HashNick/ZeroTwo-PlataformaRoboticaMultiagenteALIFE/Anexo1.pdf

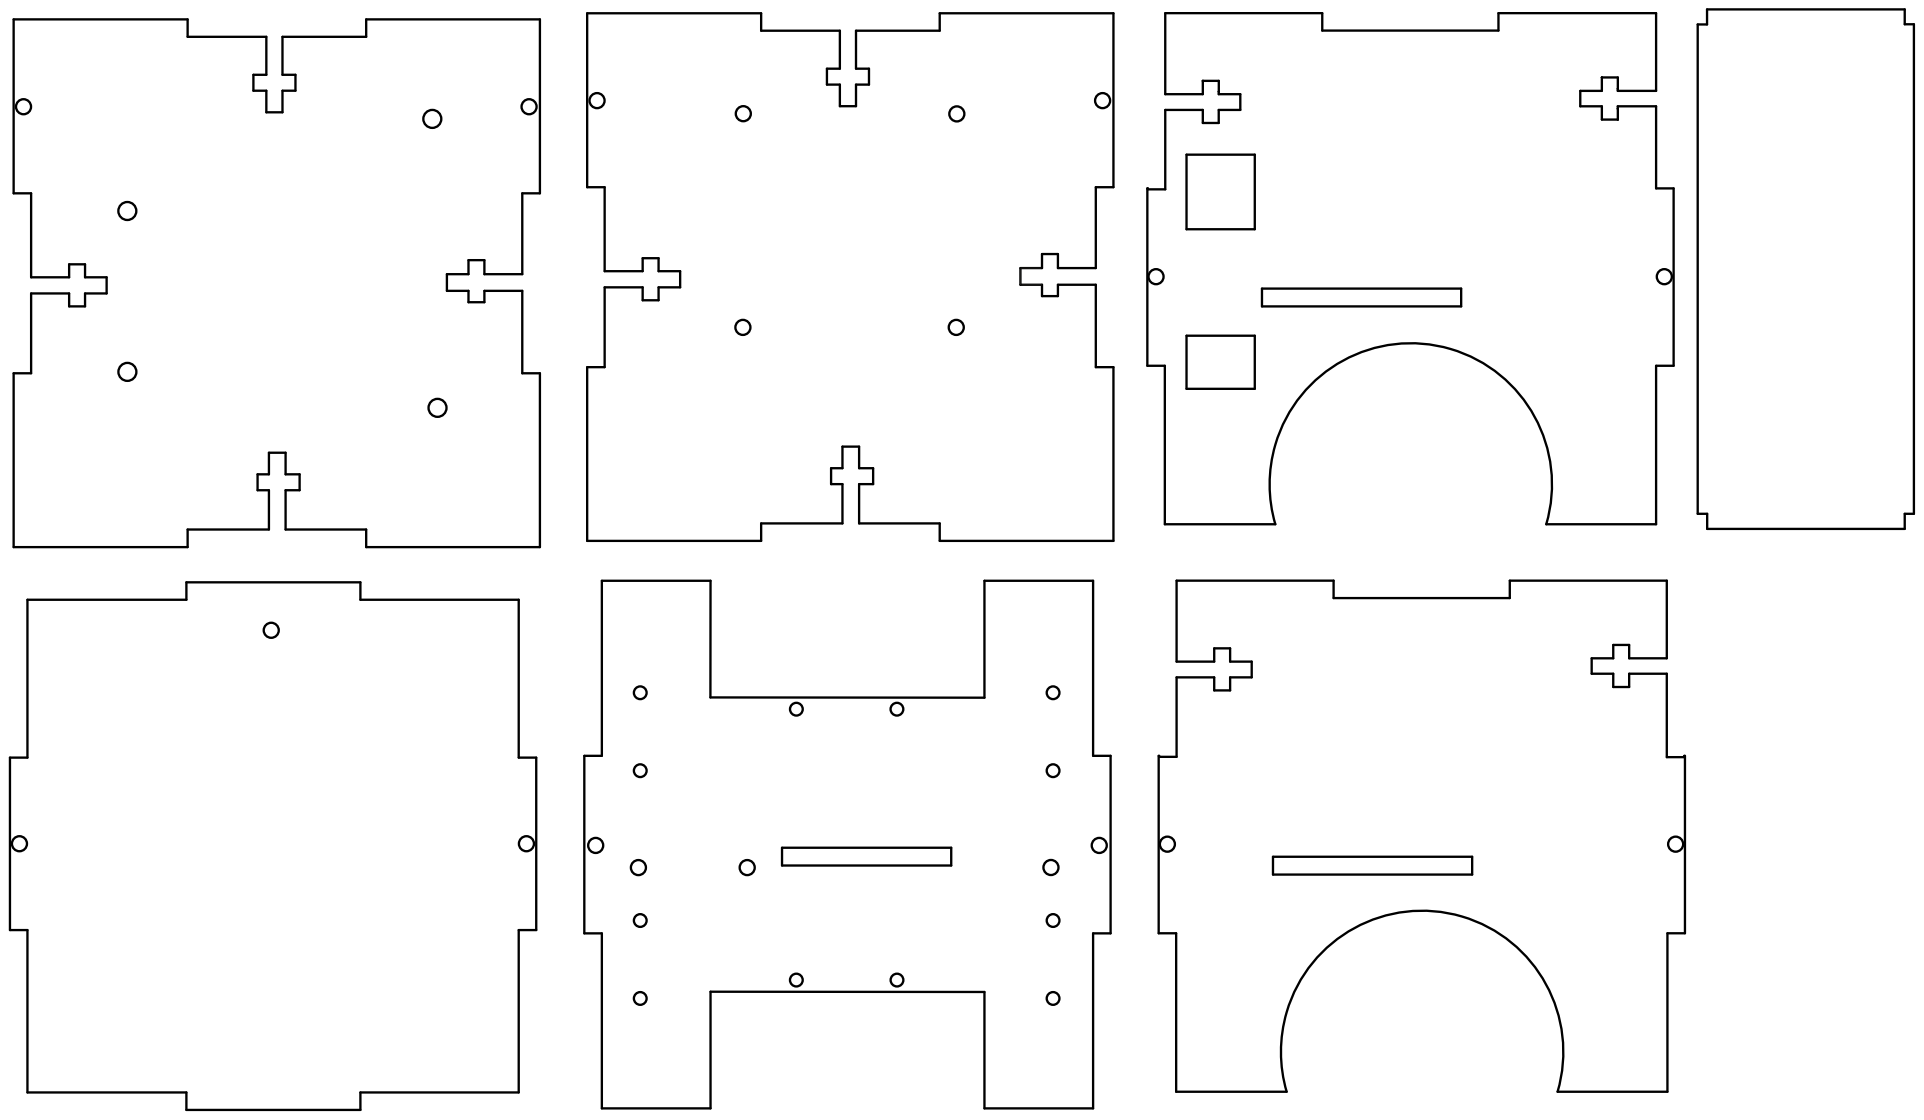
[picture p1: page 1]
