HashNick/ZeroTwo-PlataformaRoboticaMultiagenteALIFE/Anexo3.pdf

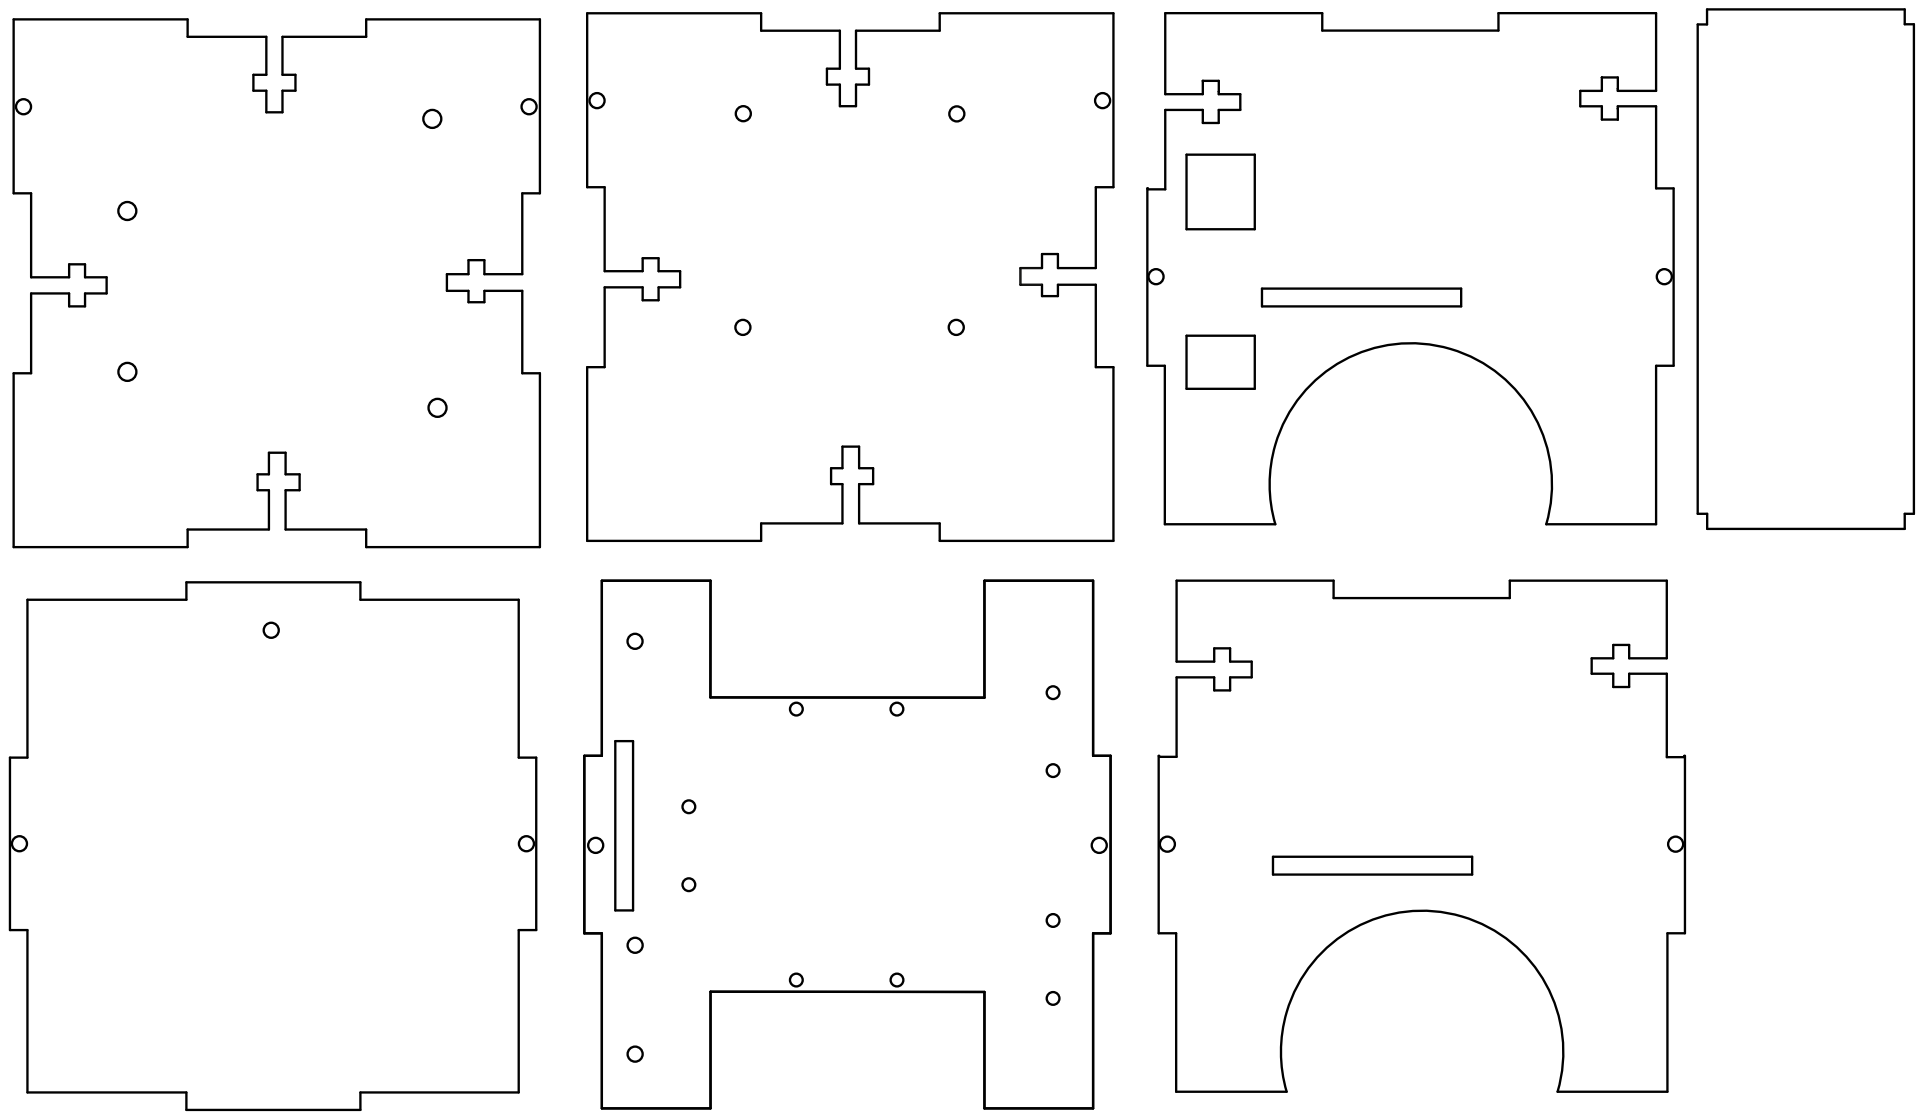
[picture p2: page 1]
